vmlopezr/ECE5330_6311_Final_Project/images/PCB_CloseUp.png

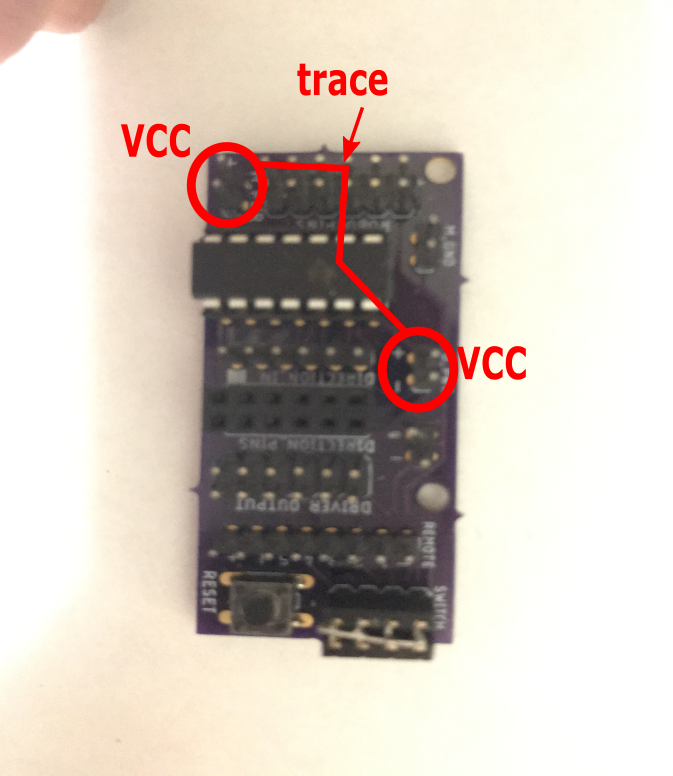
images/PCB_CloseUp.png
