vmlopezr/ECE5330_6311_Final_Project/STM32/ECE5330_Final_Project_STM32.ioc

Mcu.UserName=STM32F411VETx
PA0-WKUP.GPIO_Label=USER_BUTTON
PA0-WKUP.Signal=GPIO_Input
PA2.Signal=USART2_TX
PA3.Signal=USART2_RX
PB3.GPIO_Label=M3_IN
PB3.Signal=GPIO_Output
PB4.GPIO_Label=M4_INB
PB4.Signal=GPIO_Output
PB5.GPIO_Label=M4_IN
PB5.Signal=GPIO_Output
PB6.GPIO_Label=M5_INB
PB6.Signal=GPIO_Output
PB7.GPIO_Label=M5_IN
PB7.Signal=GPIO_Output
PD12.GPIO_Label=M1_PWM
PD12.Signal=S_TIM4_CH1
PD3.GPIO_Label=M1_INB
PD3.Signal=GPIO_Output
PD4.GPIO_Label=M1_IN
PD4.Signal=GPIO_Output
PD5.GPIO_Label=M2_INB
PD5.Signal=GPIO_Output
PD6.GPIO_Label=M2_IN
PD6.Signal=GPIO_Output
PD7.GPIO_Label=M3_INB
PD7.Signal=GPIO_Output
PE11.GPIO_Label=M4_PWM
PE11.Signal=S_TIM1_CH2
PE13.GPIO_Label=M3_PWM
PE13.Signal=S_TIM1_CH3
PE14.GPIO_Label=M2_PWM
PE14.Signal=S_TIM1_CH4
PE9.GPIO_Label=M5_PWM
PE9.Signal=S_TIM1_CH1
