vmlopezr/ECE5330_6311_Final_Project/(commit log)

2019-12-01 STM32 Project Inclusion
    Includes the STM32 project folder as well as updates to the python application and README.
    [Configuration.h]
2019-12-02 Updates.
    Updated the README to include author names at the bottom of the file.
    Included the licensing for the STM32 files, as well as the licensing for the python application.
    [Configuration.h]
2019-12-02 Updated Files
    Updated the main repository README file.
    Moved the python program to the python folder.
    Added a README file to the python and STM32 folders to give some background.
